fwu160/209-group-15/LTspice/Front end sim.asc

C1: cap; 1µF
Ca1: cap; 1.5nF
Ca2: cap; 680pF
Ca3: cap; 1.5nF
Ca4: cap; 680pF
Cb1: cap; 1.5nF
Cb2: cap; 680pF
Cb3: cap; 1.5nF
Cb4: cap; 680pF
Cif1: cap; 15nF
Cif2: cap; 15nF
Cin: cap; 47µF
Cout: cap; 22µF
Cvf1: cap; 15nF
Cvf2: cap; 15nF
D1: diode; 1N4148
D2: diode
Lload: ind; 4mH; Rser=1m
R1: res; 4.7k
R1a1a: res; 5.6k
R1a1b: res; 2.7k
R1a2: res; 12k
R1a3: res; 10k
R1a4: res; 12k
R1b1: res; 10k
R1b2: res; 12k
R1b3: res; 10k
R1b4: res; 12k
R2: res; 150k
R2a1: res; 10k
R2a2a: res; 27k
R2a2b: res; 1.5k
R2a3: res; 10k
R2a4: res; 28.5k
R2b1: res; 10k
R2b2a: res; 27k
R2b2b: res; 1.5k
R2b3: res; 10k
R2b4: res; 28.5k
R3: res; 3.3k
R4: res; 220k
R5: res; 1k
R6: res; 470k
Ra: res; 56k
Rb: res; 2.7k
Rif1: res; 1k
Rif2: res; 1k
Rin: res; 11
RL: res; 100
Rload: res; 28.52
Rsa: res; 1
Rsb: res; 1
Rvf1: res; 1k
Rvf2: res; 1k
U1: opamp2; LM324
U3: LT1086-5
U4: opamp2; LM324
U5: opamp2; LM324
U6: opamp2; LM324
U7: opamp2; LM324
U8: opamp2; LM324
U9: opamp2; LM324
V2: voltage; 2.1
V5: voltage; 5
V6: voltage; ""; AC 1
Vsupply: voltage; SINE(0 {15.4*sqrt(2)} 500); AC {15.4*sqrt(2)}
Named nets: Vis, Vvs, 0, Ideal2.1V, Vac, 5V, Vref, Vvf, Vcrossv, BodeTest, Vifbode, Ideal5V, Vvfbode, Vif, Vvobode, Viobode, Vip
.lib LM324.lib
.tran 0 0.2 0 0.02m
.ac dec 100 10 10Meg
Voltage sensing cct with 2nd order low pass filter, fcutoff at 10KHz.
This cct used to see bode plot of voltage sensing.
.op
Current sensing cct with 2nd order low pass filter, fcutoff at 10KHz.
This cct used to see bode plot of current sensing.
Voltage zero crosssing detector
Detects Vvf signal crosses the 2.1V Vref and creates a square wave.
Ideal sources used for bode plot analysis of filters
Voltage conditioning cct with 2nd order low pass filter
 
- Difference amplifier with virtual ground used to amplify and shift voltage signal. 
- Total fcutoff at 10KHz by having all poles at 10KHz. 
- Second order filter created by cascading 2 first order low pass filters together.
Current conditioning cct with 2nd order low pass filter
 
- Difference amplifier with virtual ground used to amplify and shift current shunt resistor voltage signal. 
- Total fcutoff at 10KHz by having all poles at 10KHz. 
- Second order filter created by cascading 2 first order low pass filters together.
- Idealy should be 560pF for opamp filter capacitors but had to switch 
  to 680pF since store didnt have them
Current sens: 0.5Ohm
Pmax = 180mW
Load 
(2.5VA-7.5VA)
5V DC to 2.1V using voltage divider + Voltage follower
Vref: 2.1V
Half wave rectifier with a 5V regulator to get 5V
***************************
ELECTENG 209 - Team 15
***************************
Simulation commands
- Rload is the variable resistor in the load which changes
  from 5-105 ohms.
- Vsupply is between 12.6-15.4Vrms.
Current peak detector
Analog method of measuring the peak of the signal 
(ended up not using this due to digital methods being more effective)
