fwu160/209-group-15/(list of files, drawings)

Other design files:
Proteus/Overall_Project_Proteus.pdsprj
Proteus/Proteus sim.pdsprj
