fwu160/209-group-15/Firmware/Final Implementation/Final Implementation/capture.c

/*
 * capture.c
 *
 * Created: 9/23/2026 11:05:03 PM
 *  Author: hiimf
 */ 
#include "capture.h"
#include "timer.h"
#include "adc.h"
#include "zerocross.h"


// One burst on one channel, will be used to capture V and I signals from the same relative point (rising zero crossing on V signal)
static uint8_t capture_one_burst(volatile uint16_t *buffer, uint8_t channel, uint16_t start_count)
{
	adc_select_channel(channel);      
	timer1_reset();
	TCNT1 = start_count;        

	adc_start_capture(buffer, N_SAMPLES);	// Start adc capture

	if (!zc_wait_for_edge()) {		// Real INT0 interrupt underneath; timer1_start()
		adc_stop();					// Already happened inside that ISR if it succeeded
		timer1_stop();				// Stop timer1 so it can't start even at timeout 
		return 0;
	}
	// Block loop here to wait for adc burst to finish, might need to remove if main would need to do something 
	// but burst capture should have number 1 priority as accuracy is most important 
	while (!adc_capture_done()) {
		;
	}

	timer1_stop();
	adc_stop();
	return 1;
}

capture_result_t capture_phase_locked(volatile uint16_t *v_buffer, volatile uint16_t *i_buffer)
{	
	capture_result_t result = CAPTURE_OK;		

	// Pause the report tick while sampling, it runs afterwards 
	// DONT NEED TO WORRY ABOUT THIS INTERRUPTING ADC 
	TIMSK2 &= ~(1 << OCIE2A);
	
	// If capture_one_burst for v fails it returns 0, then return CAPTURE_ERR_NO_ZC_V error code
	if (!capture_one_burst(v_buffer, ADC_CHANNEL_V, PHASE_TRIM_CYCLES)) {
		result = CAPTURE_ERR_NO_ZC_V;	
	}
	
	// If capture_one_burst for i fails it returns 0, then return CAPTURE_ERR_NO_ZC_I error code

	else if (!capture_one_burst(i_buffer, ADC_CHANNEL_I, 0)) {
		result = CAPTURE_ERR_NO_ZC_I;
	}
	
	TIMSK2 |= (1 << OCIE2A); // Turn it back on , any uart send flags will run now 
	return result;
}
