fwu160/209-group-15/Firmware/Final Implementation/Final Implementation/timer.h

/*
 * timer.h
 *
 * Created: 9/23/2026 8:34:04 PM
 *  Author: hiimf
 */ 


#ifndef TIMER_H_
#define TIMER_H_

#include "common.h"

// Timer0: Display
void timer0_init(void);
// Timer1: ADC 
void timer1_init(void);		// CTC mode, TOP = TIMER1_TOP, left stopped
void timer1_start(void);	// function to start timer1 
void timer1_stop(void);		// function to stop timer1
void timer1_reset(void);	// used to reset timer1 counter and reset all flags

// Timer2: UART
void timer2_init(void);				// CTC mode, interrupt every 99.84 ms (close to 100ms) , starts running straight away
uint8_t timer2_report_due(void);	// Returns 1 once per report period (and clears itself), otherwise 0



#endif /* TIMER_H_ */
