fwu160/209-group-15/(commit log)

2026-08-13 Created voltage and current sensing part, AC source, load, sensors and DC reg.
2026-08-14 Added uart.c and uart.h files which was created for lab 2, and will be the foundation for the uart sending firmware.
2026-08-15 Added a basic voltage zero crossing detector in ltspice simulation.
2026-08-17 Created second order filtering for V/I conditioning cct.
    Also set up ideal sources to connect to 2nd order conditioning ccts to be able to create bode plot.
2026-08-18 Added proteus sim of microcontroller to simulate sending voltage message using uart.
    [Proteus sim.pdsprj]
2026-08-19 Changed 2nd order filters so that fc now at 5kHz to reduce aliasing.
2026-08-20 Added voltage, current and power display message C code
2026-08-22 Fixed issue where digits in serial messages weren't being converted to the correct ascii code, also changed uart_transmit_string function to directly iterate through message array instead of creating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
    [main.c, uart.c, uart.h]
2026-08-23 Got rid of capacitor parallel to R2a on both V/I sensing as it was adding unessasary phase shift.
2026-08-24 Changed capacitor values back to the ideal cutoff frequency of 10kHz.
2026-08-25 Added current signal comparitor to detect current zero crossing.
2026-08-31 Created basic esp32 program using platform io dev enviroment which broadcasts atmega328p reading to devices connected to its wireless access point.
2026-09-01 upated esp32 code to work properly with basic website that receives the data. ATmega uart code also updated to send uart data in a format esp32 knows.
2026-09-08 Edted esp32 software to serve a html site which has the power monitor when person connects to the access point.
2026-09-23 upated esp32 web portal code to have a nicer looking graph, changed the access point to a public network and tested and confimred to work on android devices.
2026-09-23 Created files needed to impliment adc sampling of V and I signals, only timer, and zerocross files implemented fully.
2026-09-24 Implemented adc and common files, updated main file so it does the V and I signal captures.
2026-10-08 changed esp32 config file so it doenst use tx as the 3.3V default was powering the board which was unwanted. Created calculation c/h file for atmega to be able to calculate values.
2026-10-08 esp32 now expects to receive phase data, changed portal to display phase as well.
2026-10-09 Updated common.h file for making timer1 control uart sending
    planning to make uart send every 0.5 sec from atmega, esp will make sure it sends uart through usb every 1 sec
2026-10-09 INT0 pin fixed to be set as input, fixed comments
    [capture.c, common.h, timer.c, uart.c, zerocross.c]
2026-10-09 Fixed adc sample array overflowing issue
    discard readings after 200 readings are taken
    [adc.c]
2026-10-09 Calculate phase diff, tweaked how values are calculated
    Phase diff between V and I signals are now being calculated, with many different ways being used. Since uart only sends every 0.5s, can average values over 5 ish burst measurements. Implemented function that also finds exactly how many samples per period to make sure values calculated over whole sample periods.
2026-10-09 Timer2 used to queue when to send uart
2026-10-09 Main file done, uart sends out every 0.5 sec
2026-10-12 added display code to display power
2026-10-13 Phase diff of around 3 degrees found between V and I conditioning signal, firmware fix implemented
    Offsetting when voltage signal is taken from zero crossing to fix this phase diff, need to recalibrate K_I, K_V and PHASE_TRIM_CYCLES again
    [capture.c, common.h]
2026-10-13 Fixed startup edge case, fixed comments
    Fixed issue where on startup there would be a brief window where adc bursts could be taken at a point not at the rising zero crossing. Lots of random comments from debugging deleted, old code not being used also deleted.
    [common.h, zerocross.c, zerocross.h]
2026-10-13 Fixing even more edge case mistakes, tidying up comments
    2 mistakes were canceling each others effects out so fixed that, using define consts more, fixing some comments that dont make sense
    [adc.c, capture.c, timer.c]
2026-10-13 Redid the display code as it was hardcode for just power
    Initial testing to see if disp work so hardcoded to only display power, that function sucked and was annoying to make it work for many different types of values and decimal places so just remade the function display_show_fixed so i can display a range of values with different amounts of values and decimal point pos.
2026-10-16 atmega calculates energy from startup
    uses the uart timer that we use to send uart every 0.5s to calculate energy usage by multiplying time and power value together. energy will be outputed in J, sends it to esp to be processed
2026-10-16 updated esp dashboard to now display energy sent by atmega through uart and captive portal
2026-10-17 corrected the energy calculation to update constantly and not just report the last 0.5s
    [main.c]
2026-10-17 updating the ADC count values as per test results and commenting clear explanations.
2026-10-18 fixed shunt resitor value comment mistake
    [common.h]
2026-10-19 changed phase trim to 18, added overall proteus file
    [Overall_Project_Proteus.pdsprj]
2026-10-19 display now shows letter to show what is currently being displayed
